chipfoundry/sky130-fabulous-testchip/img/packaging.png

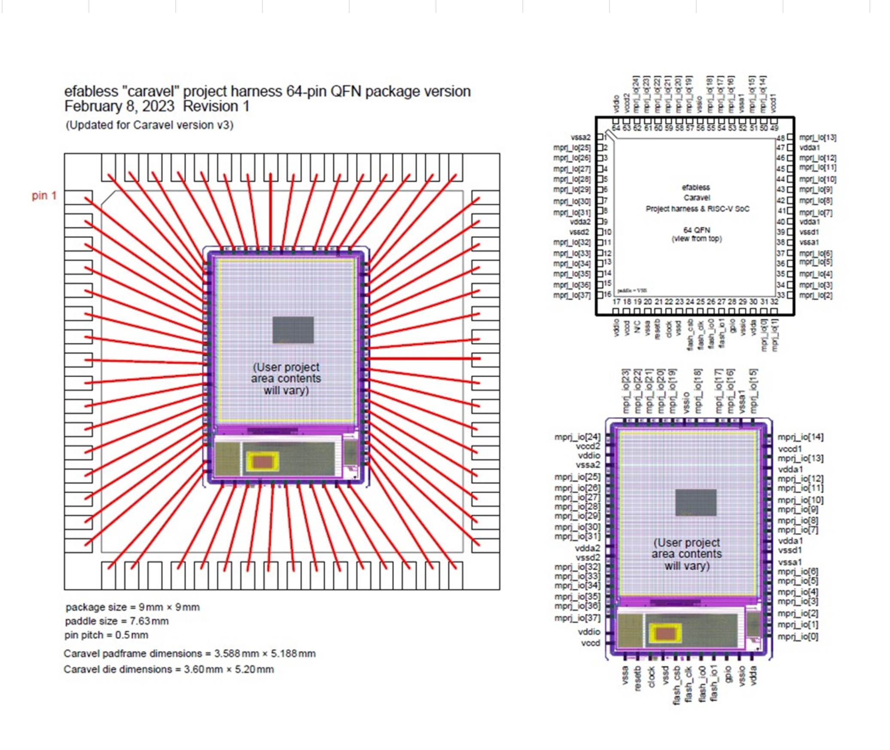
img/packaging.png
