chipfoundry/sky130-fabulous-testchip/user_designs/fabrics/classic_fabric_chipfoundry_large/macro/sky130A/fabulous/classic_fabric_chipfoundry_large.v

module classic_fabric_chipfoundry_large
    #(
        parameter MaxFramesPerCol=20,
        parameter FrameBitsPerRow=32
    )
    (
        input  Tile_X0Y1_A_OUT_top, //EXTERNAL
        output  Tile_X0Y1_A_IN_top, //EXTERNAL
        output  Tile_X0Y1_A_EN_top, //EXTERNAL
        input  Tile_X0Y1_B_OUT_top, //EXTERNAL
        output  Tile_X0Y1_B_IN_top, //EXTERNAL
        output  Tile_X0Y1_B_EN_top, //EXTERNAL
        input  Tile_X14Y1_A_OUT_top, //EXTERNAL
        output  Tile_X14Y1_A_IN_top, //EXTERNAL
        output  Tile_X14Y1_A_EN_top, //EXTERNAL
        input  Tile_X0Y2_A_OUT_top, //EXTERNAL
        output  Tile_X0Y2_A_IN_top, //EXTERNAL
        output  Tile_X0Y2_A_EN_top, //EXTERNAL
        input  Tile_X0Y2_B_OUT_top, //EXTERNAL
        output  Tile_X0Y2_B_IN_top, //EXTERNAL
        output  Tile_X0Y2_B_EN_top, //EXTERNAL
        input  Tile_X14Y2_A_OUT_top, //EXTERNAL
        output  Tile_X14Y2_A_IN_top, //EXTERNAL
        output  Tile_X14Y2_A_EN_top, //EXTERNAL
        input  Tile_X0Y3_A_OUT_top, //EXTERNAL
        output  Tile_X0Y3_A_IN_top, //EXTERNAL
        output  Tile_X0Y3_A_EN_top, //EXTERNAL
        input  Tile_X0Y3_B_OUT_top, //EXTERNAL
        output  Tile_X0Y3_B_IN_top, //EXTERNAL
        output  Tile_X0Y3_B_EN_top, //EXTERNAL
        input  Tile_X14Y3_A_OUT_top, //EXTERNAL
        output  Tile_X14Y3_A_IN_top, //EXTERNAL
        output  Tile_X14Y3_A_EN_top, //EXTERNAL
        input  Tile_X0Y4_A_OUT_top, //EXTERNAL
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
wire[15:0] Tile_X4Y11_N4BEG;
wire[15:0] Tile_X4Y11_NN4BEG;
wire[3:0] Tile_X4Y11_E1BEG;
wire[7:0] Tile_X4Y11_E2BEG;
wire[7:0] Tile_X4Y11_E2BEGb;
wire[15:0] Tile_X4Y11_EE4BEG;
wire[11:0] Tile_X4Y11_E6BEG;
wire[3:0] Tile_X4Y11_S1BEG;
wire[7:0] Tile_X4Y11_S2BEG;
wire[7:0] Tile_X4Y11_S2BEGb;
wire[15:0] Tile_X4Y11_S4BEG;
wire[15:0] Tile_X4Y11_SS4BEG;
wire[3:0] Tile_X4Y11_W1BEG;
wire[7:0] Tile_X4Y11_W2BEG;
wire[7:0] Tile_X4Y11_W2BEGb;
wire[15:0] Tile_X4Y11_WW4BEG;
wire[11:0] Tile_X4Y11_W6BEG;
wire[0:0] Tile_X4Y11_CO;
wire[3:0] Tile_X5Y11_N_GBUF_BEG;
wire[3:0] Tile_X5Y11_N1BEG;
wire[7:0] Tile_X5Y11_N2BEG;
wire[7:0] Tile_X5Y11_N2BEGb;
wire[15:0] Tile_X5Y11_N4BEG;
wire[15:0] Tile_X5Y11_NN4BEG;
wire[3:0] Tile_X5Y11_E1BEG;
wire[7:0] Tile_X5Y11_E2BEG;
wire[7:0] Tile_X5Y11_E2BEGb;
wire[15:0] Tile_X5Y11_EE4BEG;
wire[11:0] Tile_X5Y11_E6BEG;
wire[3:0] Tile_X5Y11_S1BEG;
wire[7:0] Tile_X5Y11_S2BEG;
wire[7:0] Tile_X5Y11_S2BEGb;
wire[15:0] Tile_X5Y11_S4BEG;
wire[15:0] Tile_X5Y11_SS4BEG;
wire[3:0] Tile_X5Y11_W1BEG;
wire[7:0] Tile_X5Y11_W2BEG;
wire[7:0] Tile_X5Y11_W2BEGb;
wire[15:0] Tile_X5Y11_WW4BEG;
wire[11:0] Tile_X5Y11_W6BEG;
wire[3:0] Tile_X6Y11_N_GBUF_BEG;
wire[3:0] Tile_X6Y11_N1BEG;
wire[7:0] Tile_X6Y11_N2BEG;
wire[7:0] Tile_X6Y11_N2BEGb;
wire[15:0] Tile_X6Y11_N4BEG;
wire[15:0] Tile_X6Y11_NN4BEG;
wire[3:0] Tile_X6Y11_E1BEG;
wire[7:0] Tile_X6Y11_E2BEG;
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
