chipfoundry/sky130-fabulous-testchip/(commit log)

2026-05-01 Adjust classic_fabric_chipfoundry_large
    [classic_fabric_chipfoundry_large.csv]
2026-05-06 (much) better core ring, add antennas to enable
2026-05-07 Antenna ECO step
